SchreberjugendBV/DigitZ/StevensonScreen/README.md

In this folder you can find everythin you need to print and mount your own Stevenson Screen to protect temeraturesensor from sunlight
1.) Drawing as PDF
2.) 3mf file to print all parts on your 3D printer
3.) Autodesk Fusion file F3Z of the assembly with all parts. Feel free to modyfy and optimize the design.
Things to buy:
3 pcs of threaded bar M3
6 pcs distance bolts M3x10 brass
1 pc hex-screw M5x16 or longer
