SchreberjugendBV/DigitZ/Housing/chimney.stl

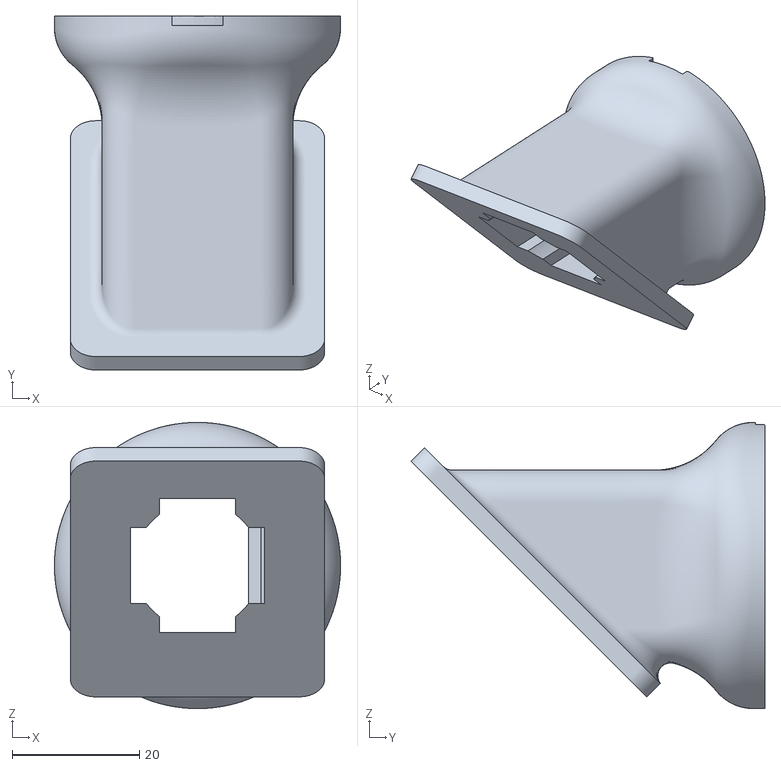
[picture p1: CAD file, 2025-11-23]
Housing/chimney.stl
45.0 x 55.7 x 45.0
