SchreberjugendBV/DigitZ/StevensonScreen/StevensonScreen_for_BambulabX1Carbon.3mf

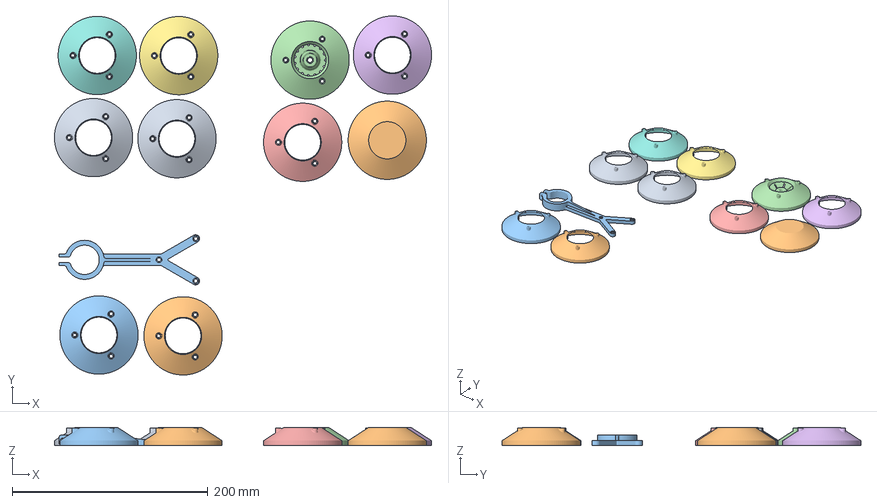
[picture p2: CAD file, 2025-11-19]
StevensonScreen/StevensonScreen_for_BambulabX1Carbon.3mf
385.5 x 367.0 x 18.6 mm
Shield v6.stl x 8
Top v3.obj
Stephenson_Halter v4.stl
Bottom v7.stl
