SchreberjugendBV/DigitZ/(list of files, cad)

Other CAD files:
Housing/Chimney.f3d
StevensonScreen/StevensonScreen.f3z
