SchreberjugendBV/DigitZ/Housing/HousingDrawings.pdf

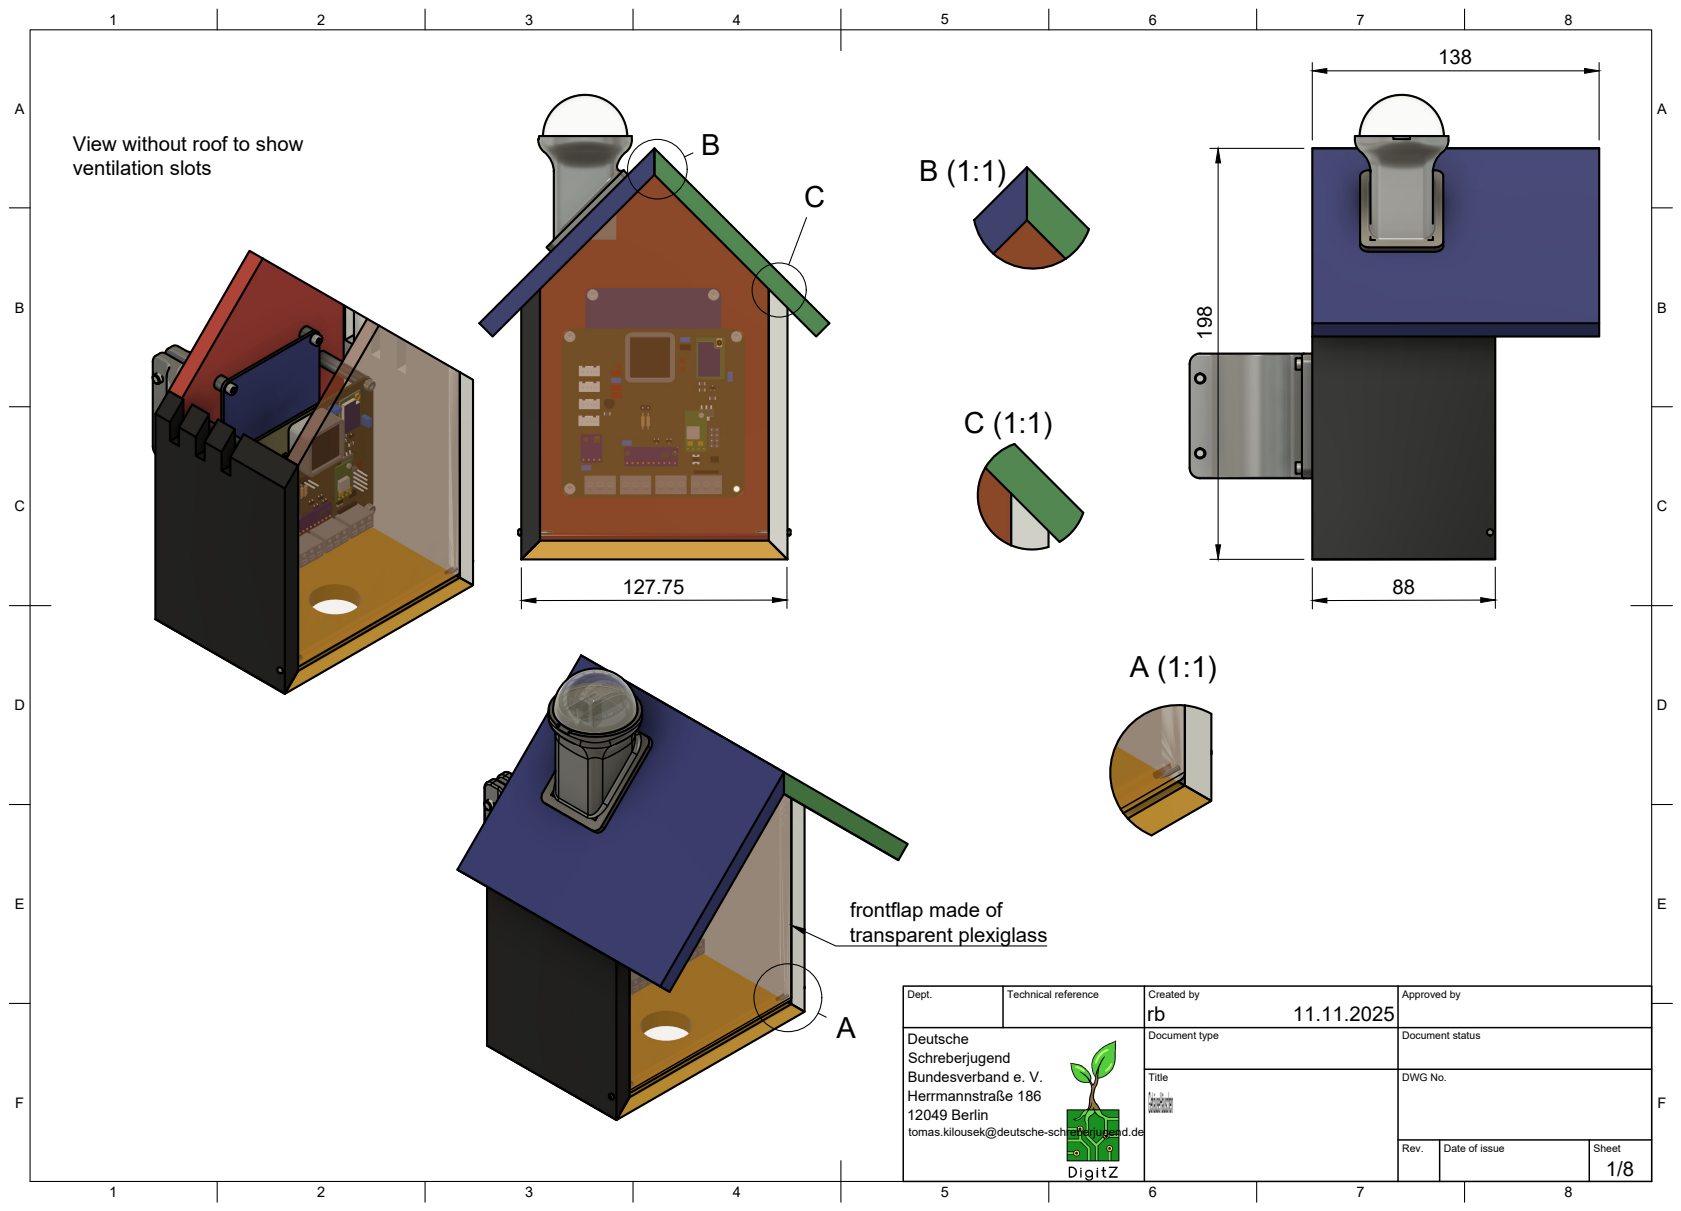
[picture p3: page 1]
Title; DWG No.; Rev.; Date of issue; Sheet

View without roof to show
ventilation slots

frontflap made of
transparent plexiglass

Dept. | Technical reference | Created by rb 11.11.2025 | Approved by

Deutsche
Schreberjugend
Bundesverband e. V.
Herrmannstraße 186
12049 Berlin
tomas.kilousek@deutsche-schreberjugend.de

Document type | Document status

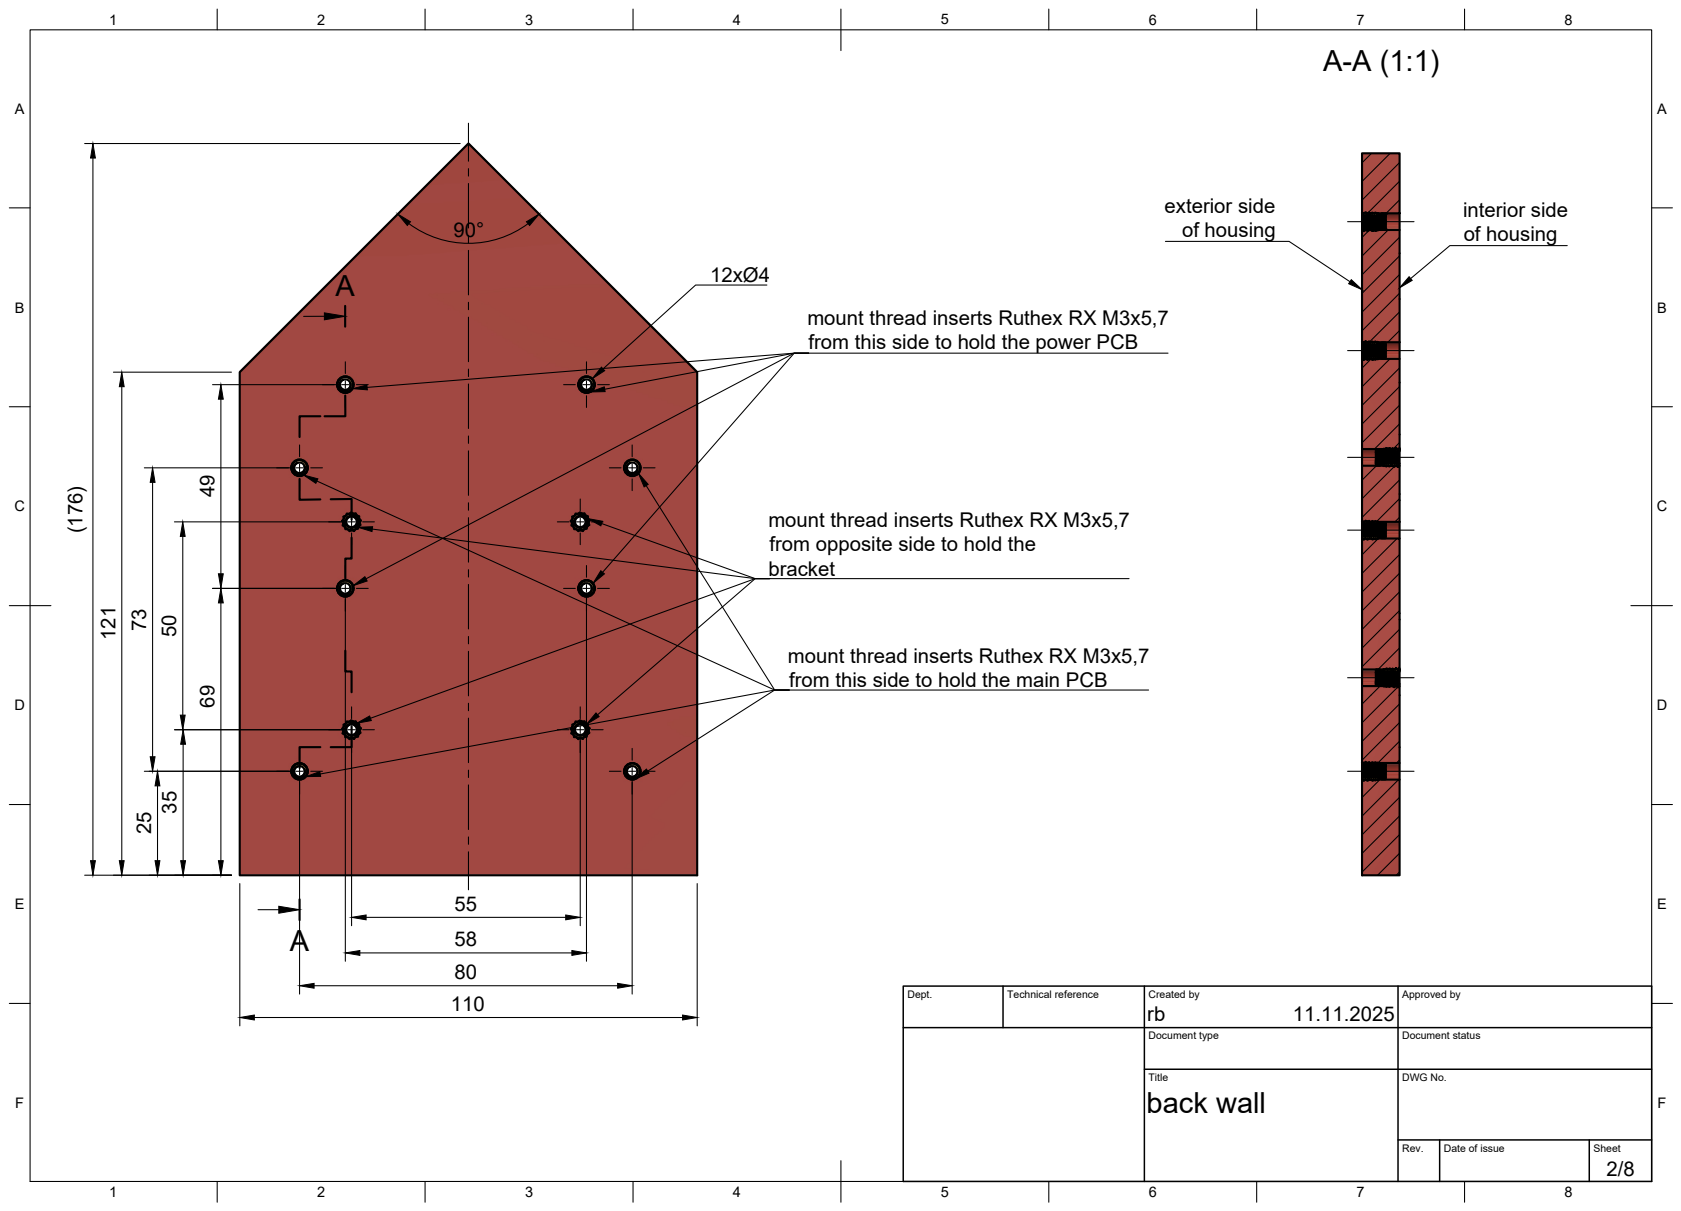
[picture p4: page 2]
Title; DWG No.; back wall; bracket 121; exterior side of housing; interior side of housing

mount thread inserts Ruthex RX M3x5,7
from this side to hold the power PCB

from opposite side to hold the

from this side to hold the main PCB

Dept. | Technical reference | Created by 11.11.2025 | Approved by

Document type | Document status

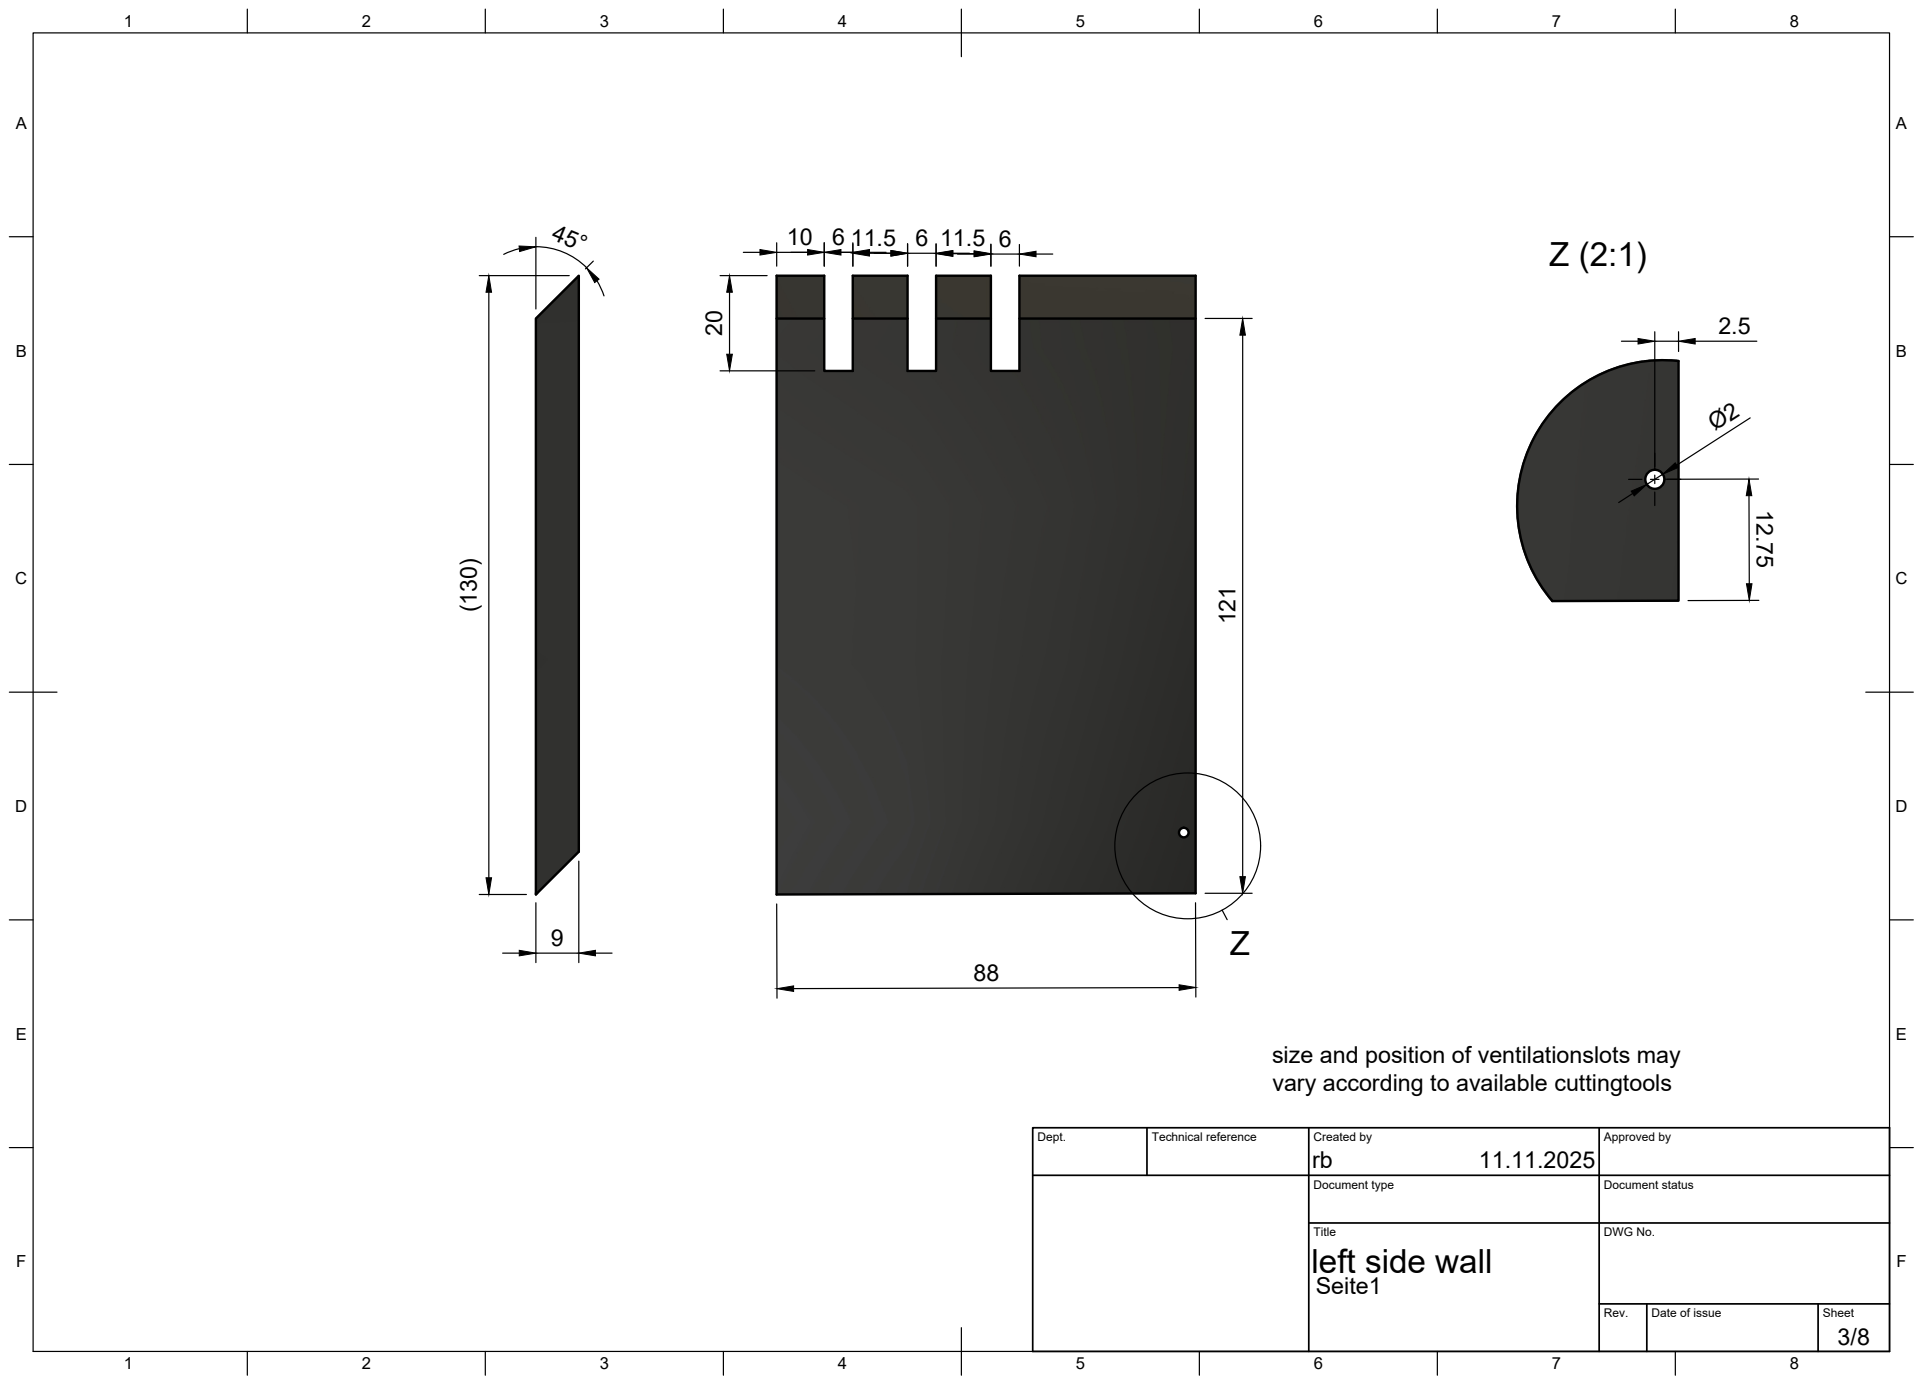
[picture p5: page 3]
Title; DWG No.

vary according to available cuttingtools 20

size and position of ventilationslots may

Dept. | Technical reference | Created by rb 11.11.2025 | Approved by

Document type | Document status

left side wall

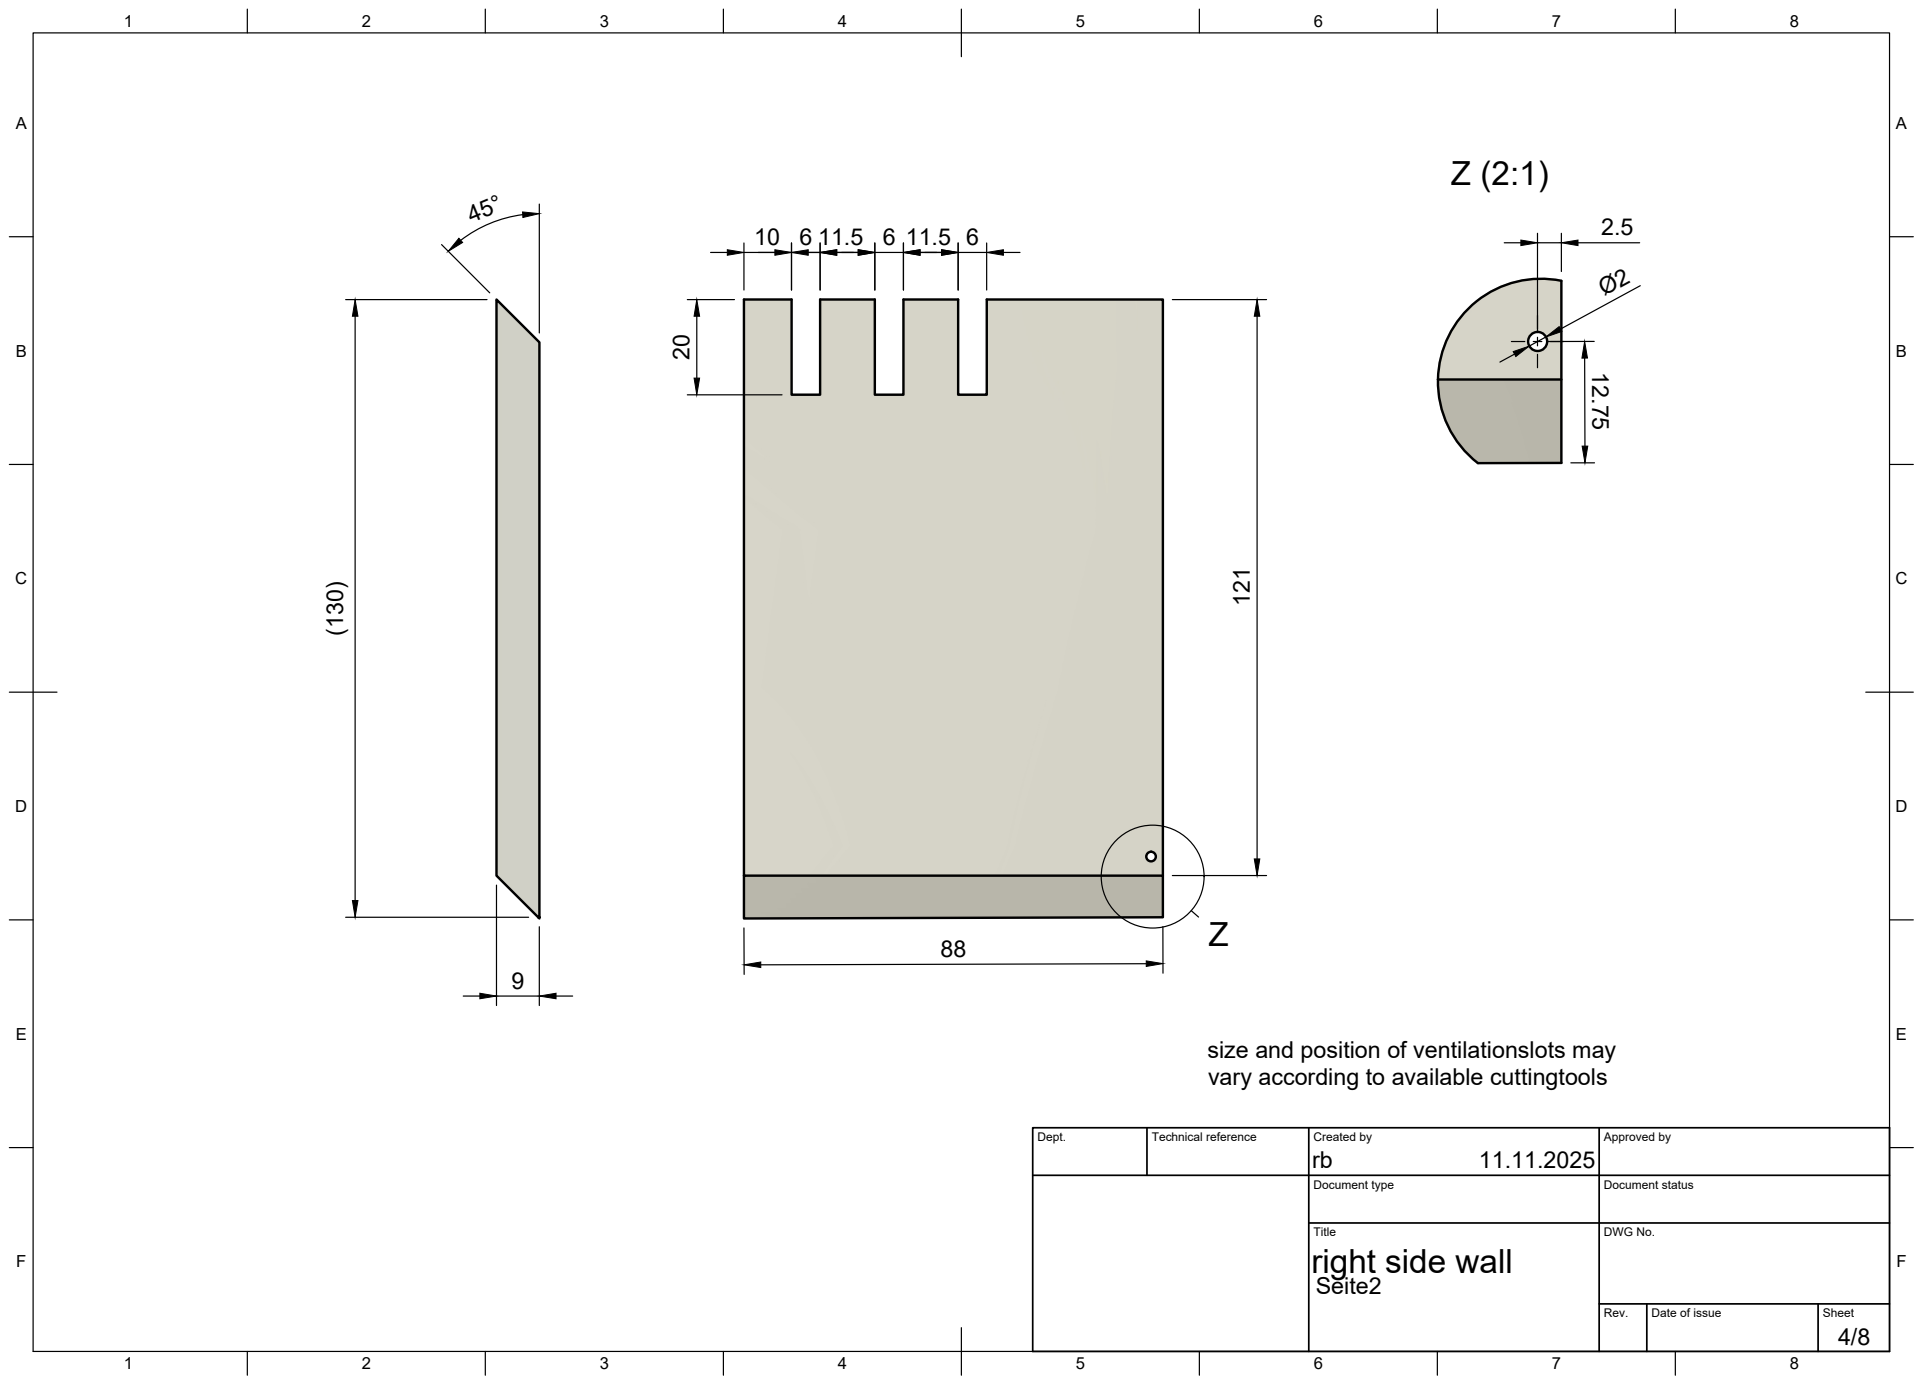
[picture p6: page 4]
Title; DWG No.

size and position of ventilationslots may
vary according to available cuttingtools

Dept. | Technical reference | Created by rb 11.11.2025 | Approved by

Document type | Document status

right side wall

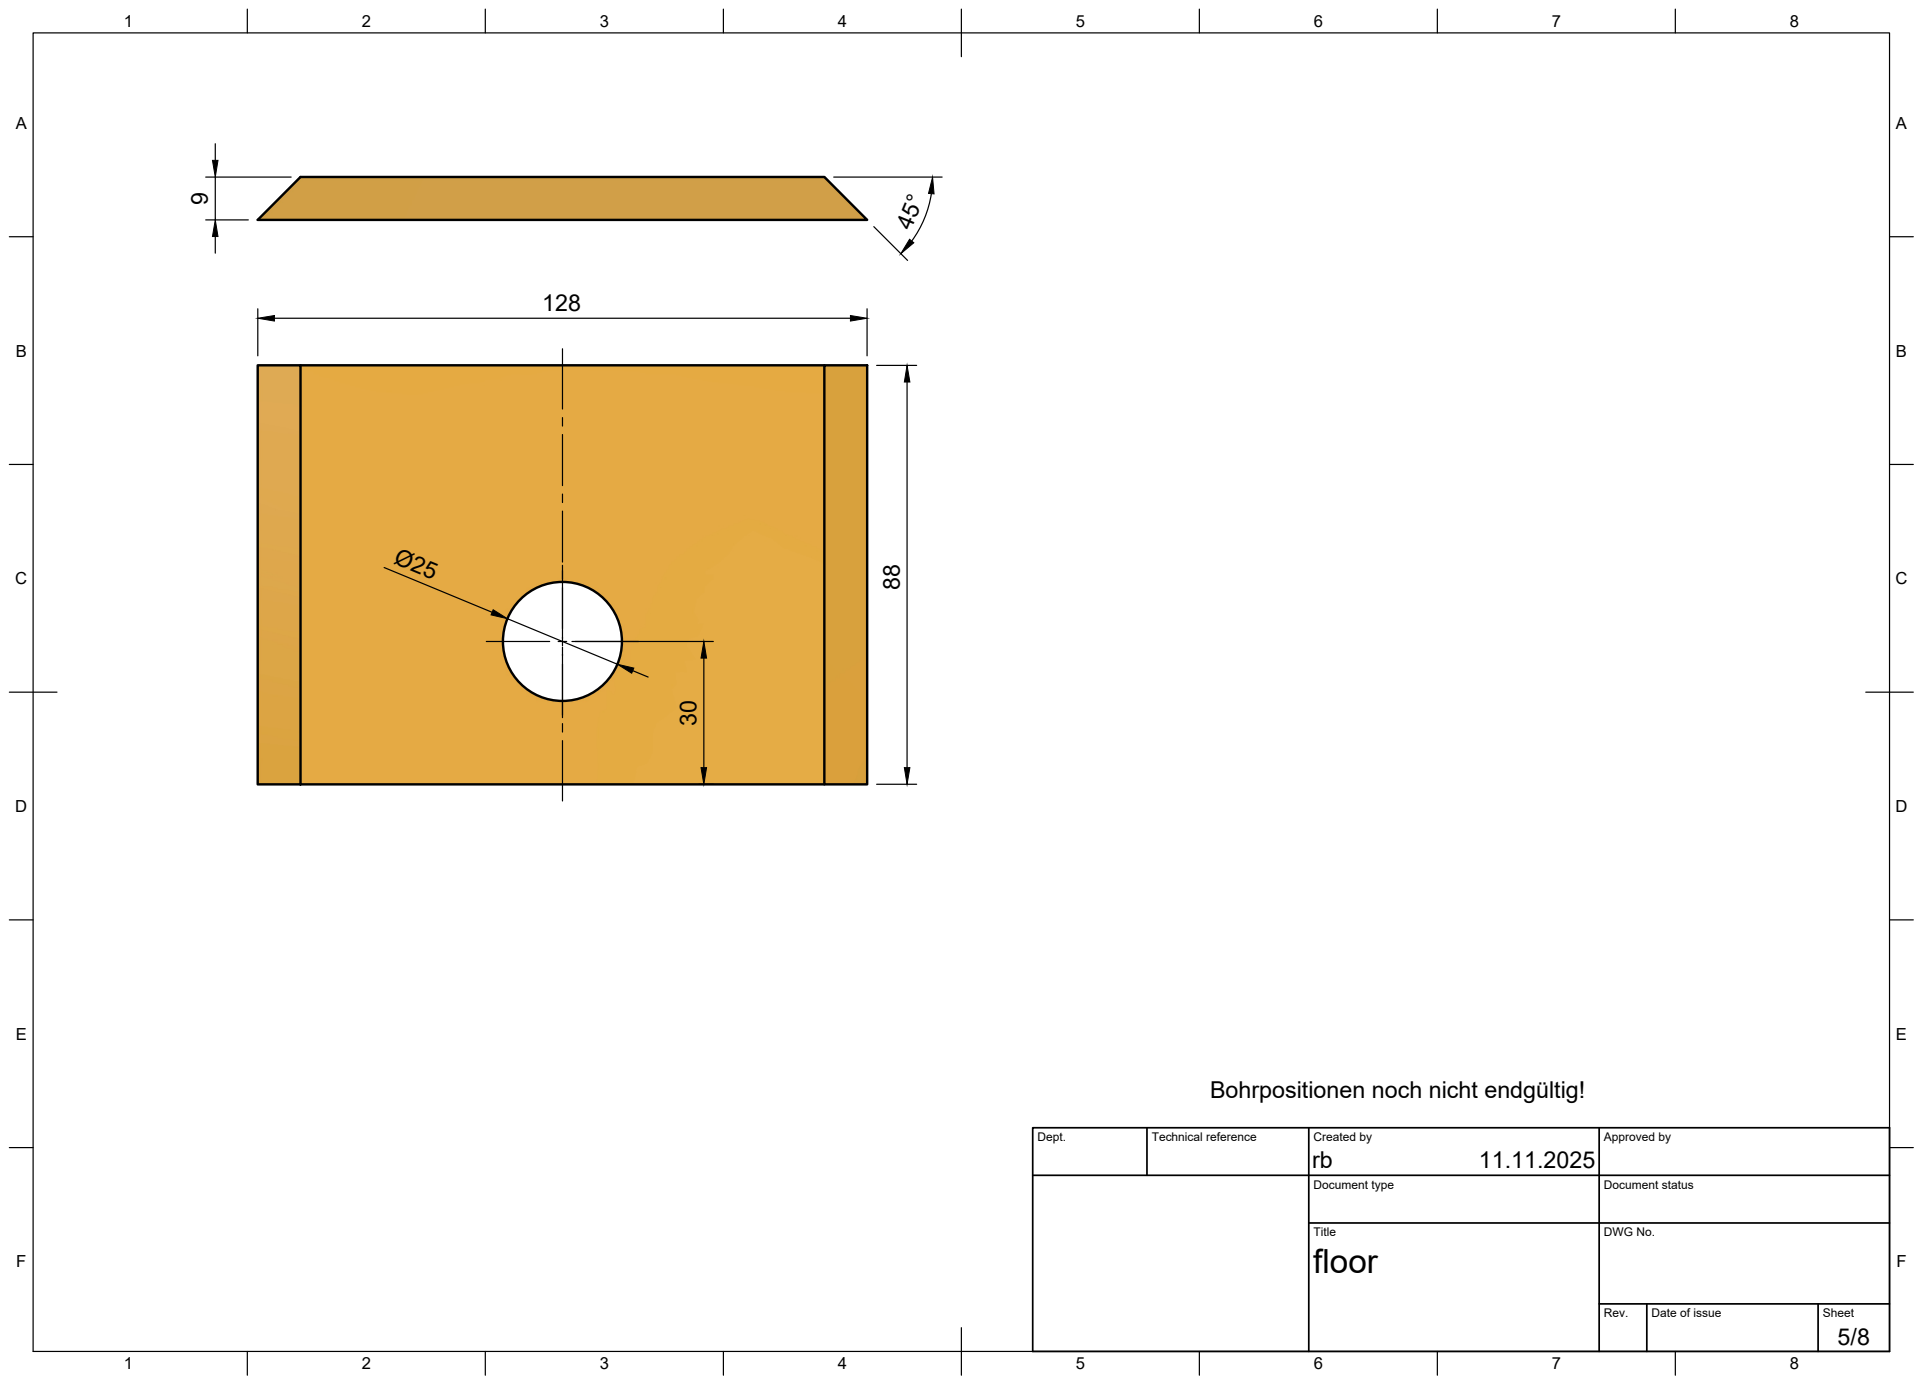
[picture p7: page 5]
Title; DWG No.

Bohrpositionen noch nicht endgültig!

Dept. | Technical reference | Created by rb 11.11.2025 | Approved by

Document type | Document status

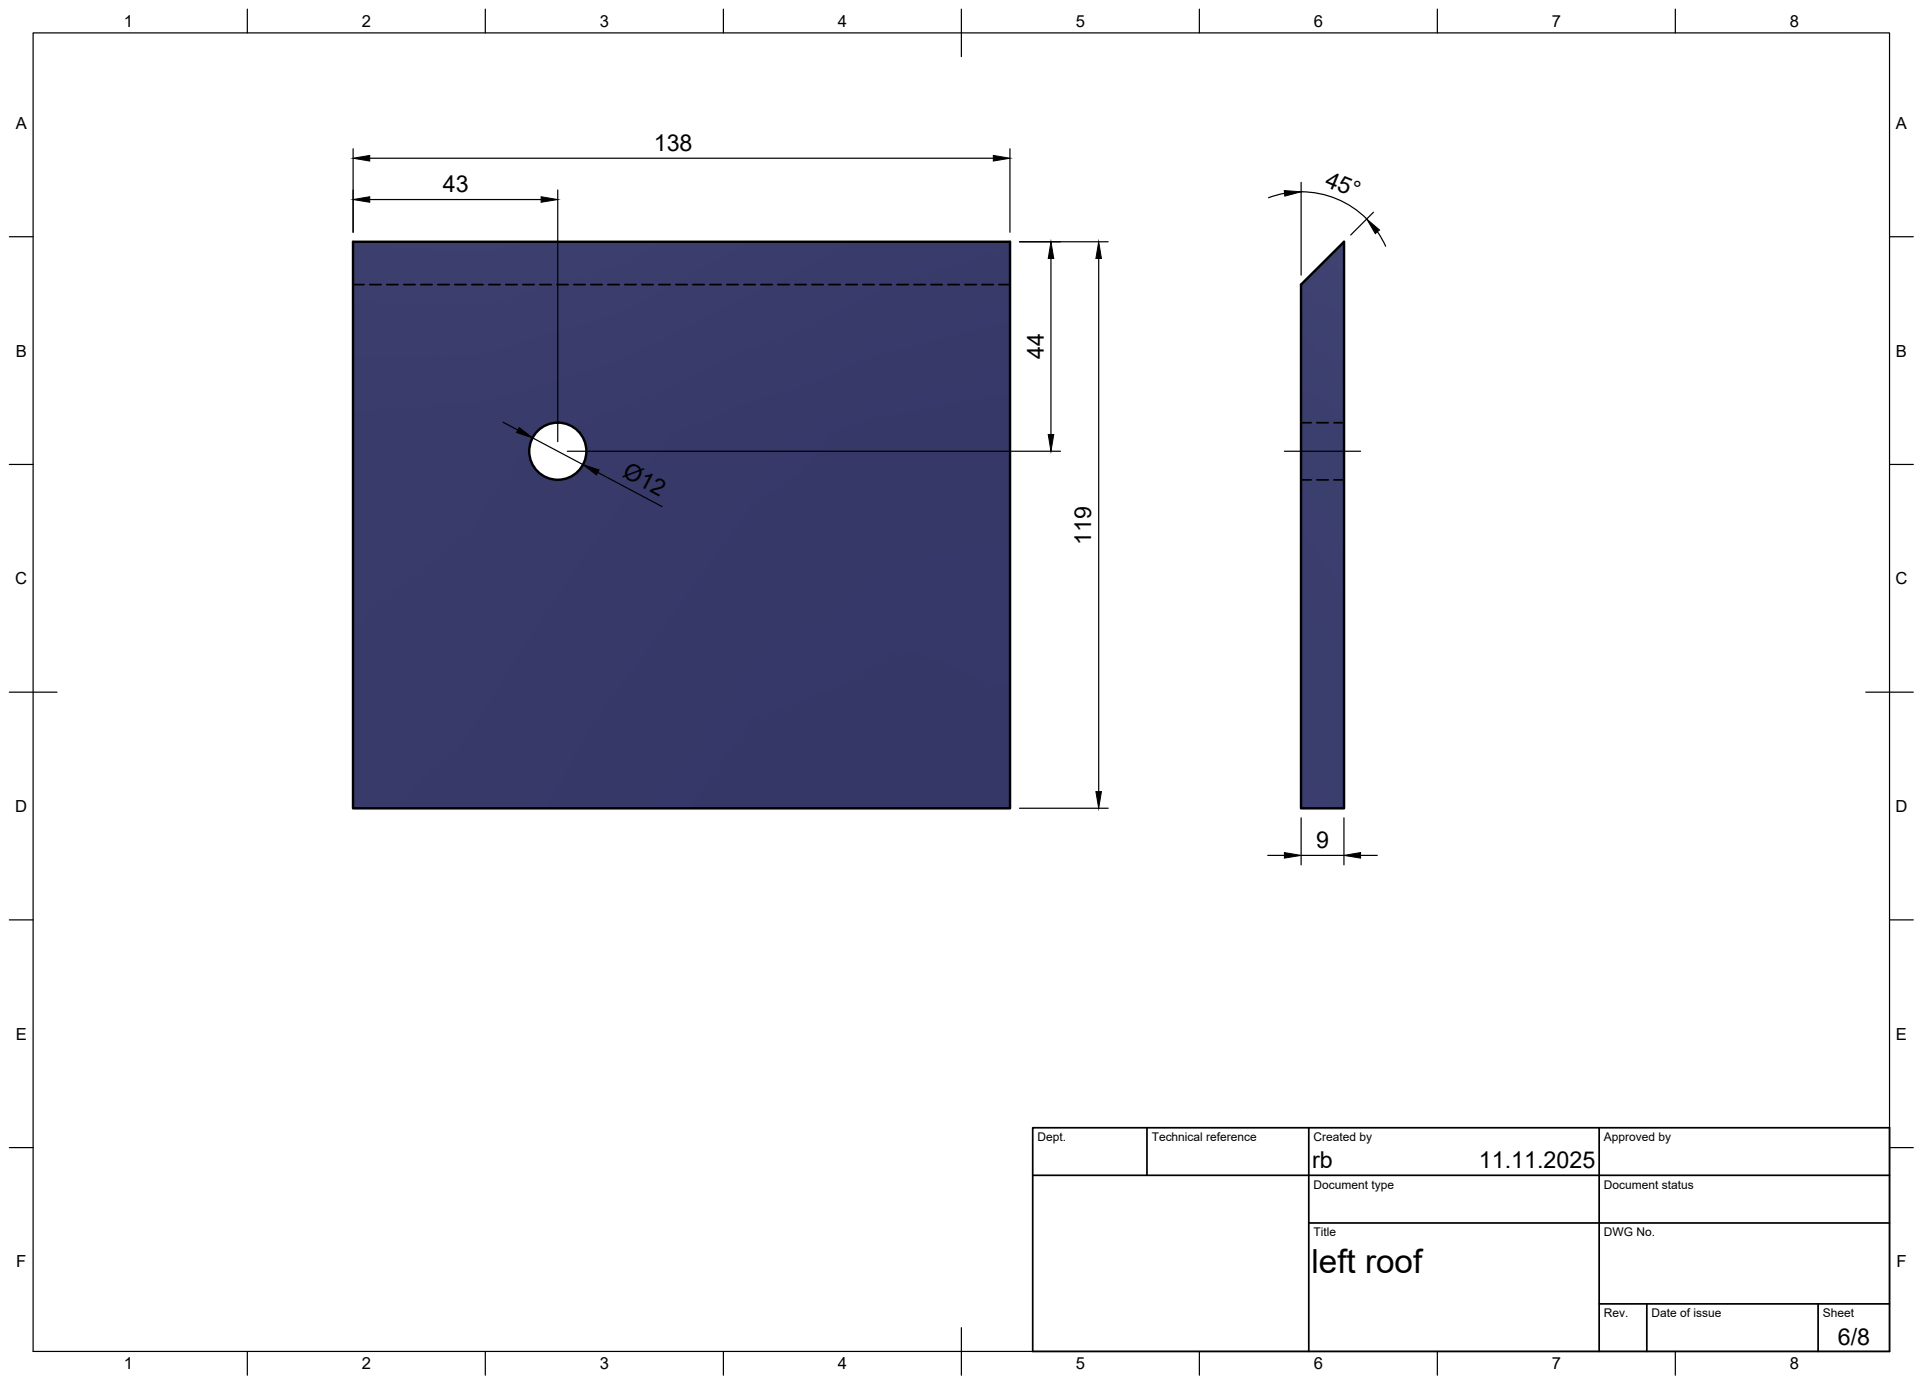
[picture p8: page 6]
Title; DWG No.; left roof

Dept. | Technical reference | Created by rb 11.11.2025 | Approved by

Document type | Document status

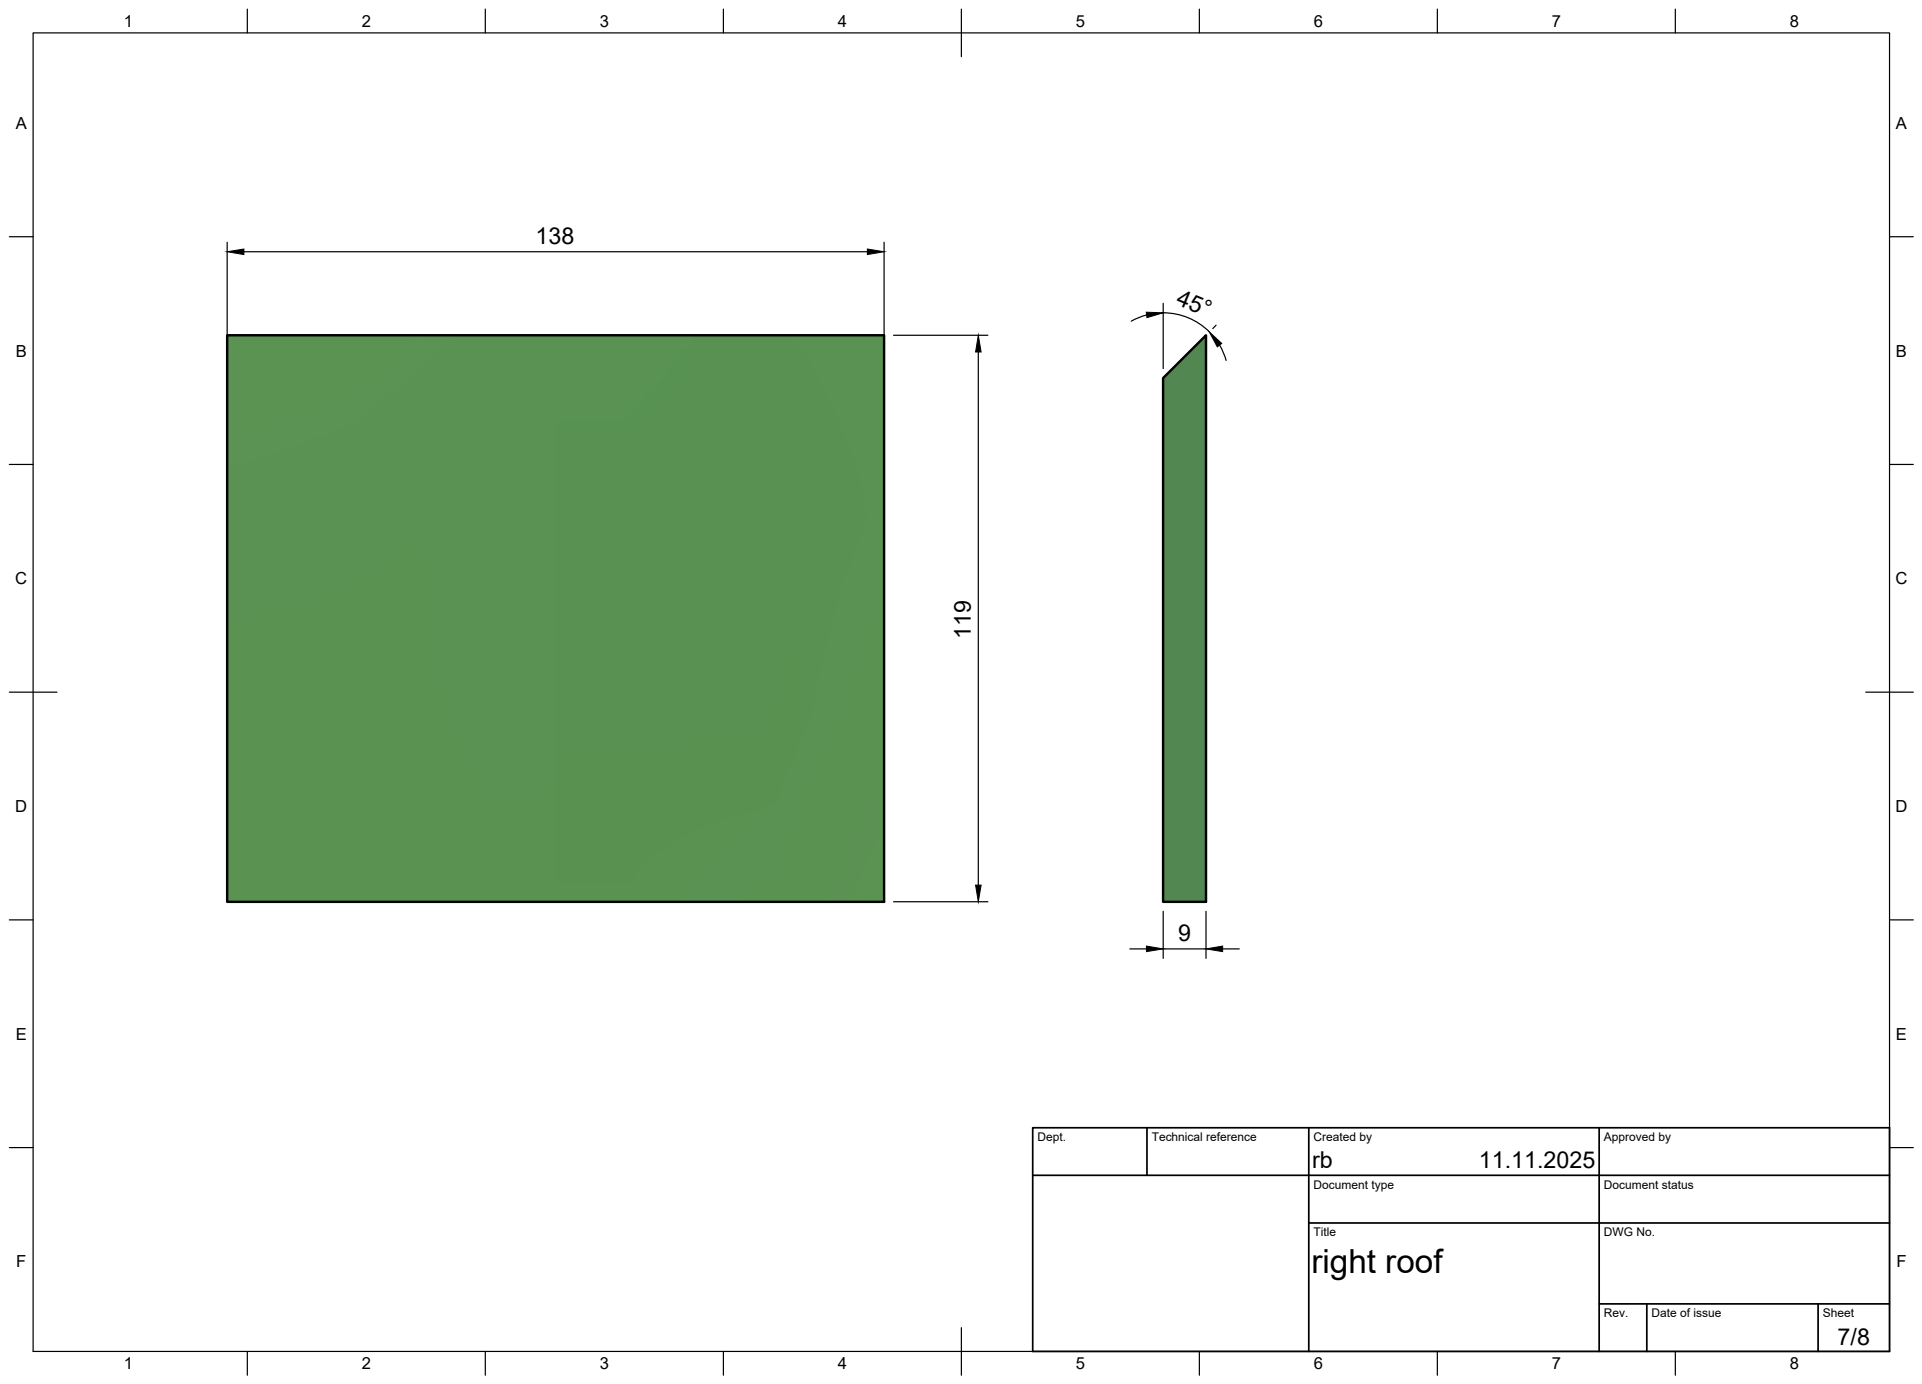
[picture p9: page 7]
Title; DWG No.; right roof

Dept. | Technical reference | Created by rb 11.11.2025 | Approved by

Document type | Document status

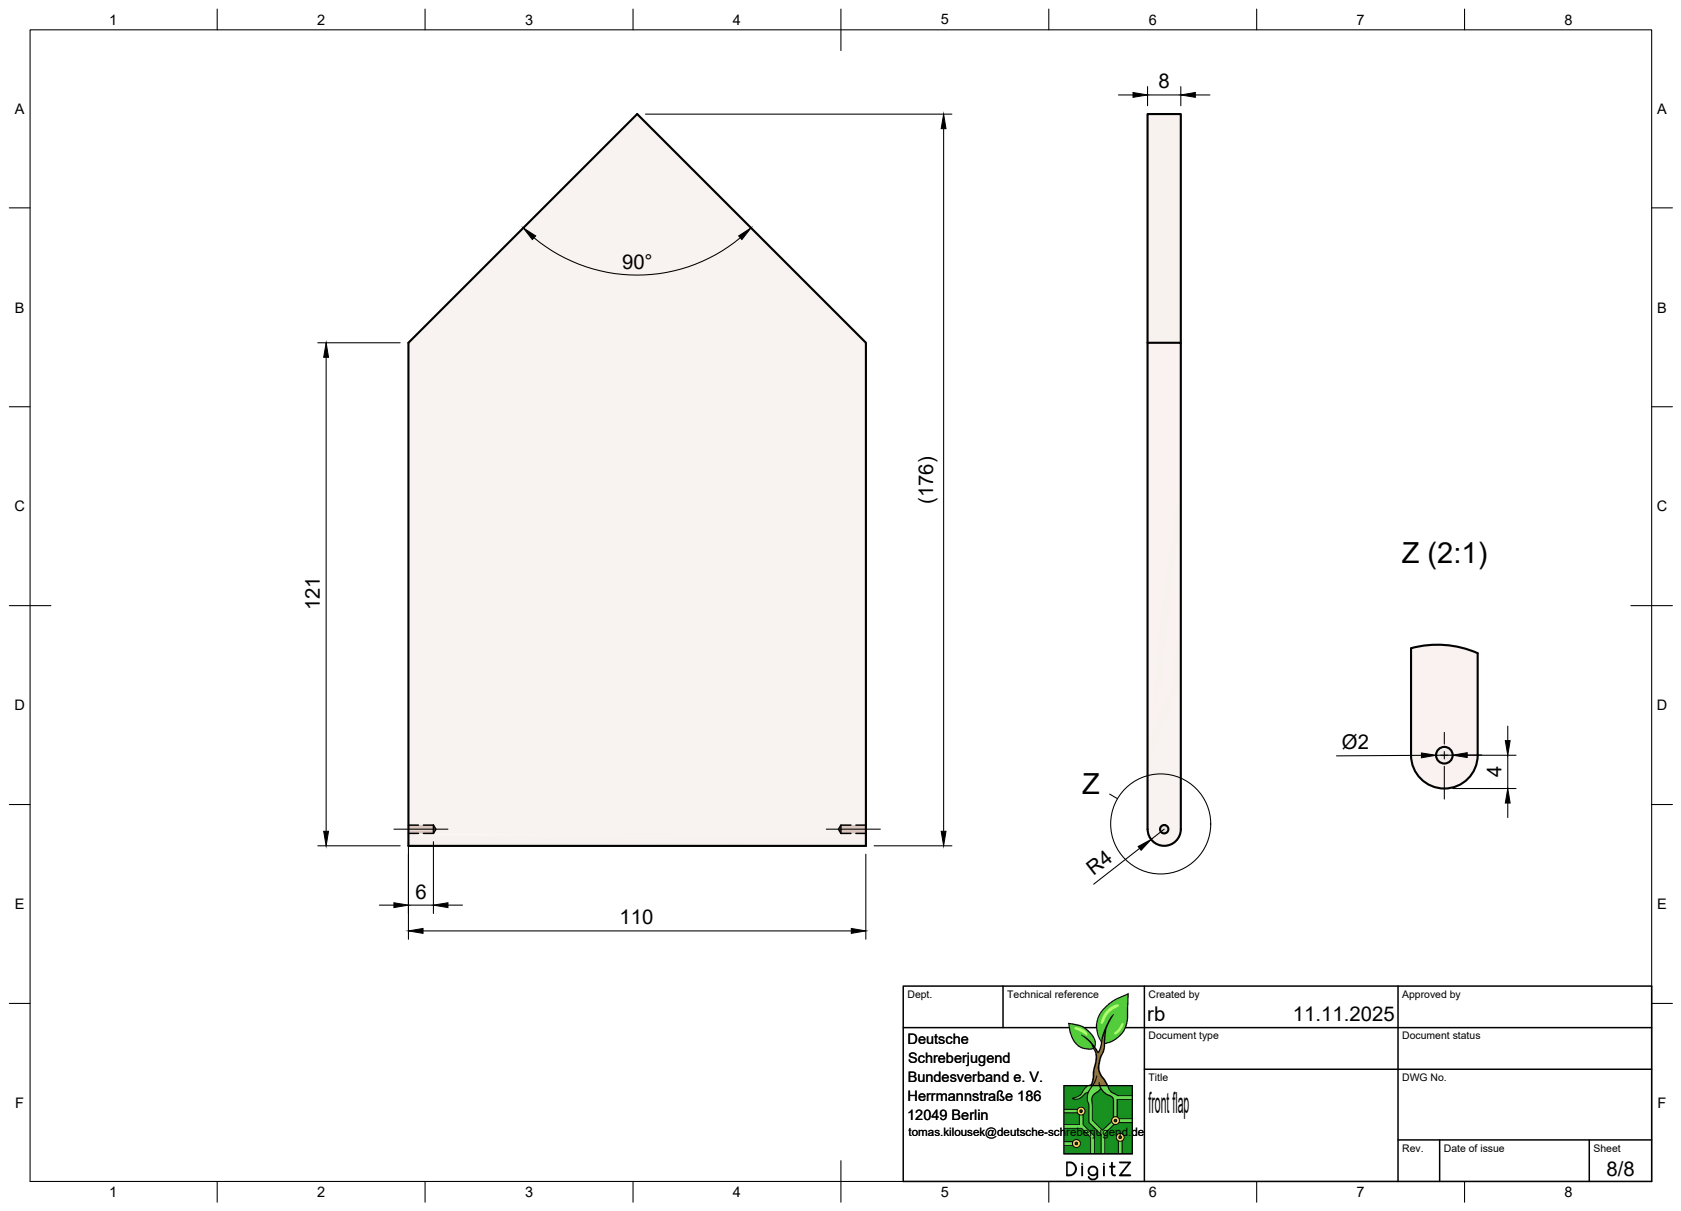
[picture p10: page 8]
Title; DWG No.; front flap

Dept. | Technical reference | Created by rb 11.11.2025 | Approved by

Deutsche
Schreberjugend
Bundesverband e. V.
Herrmannstraße 186
12049 Berlin
tomas.kilousek@deutsche-schreberjugend.de

Document type | Document status
