SchreberjugendBV/DigitZ/Main-PCB/Sensorboard-BRD.pdf

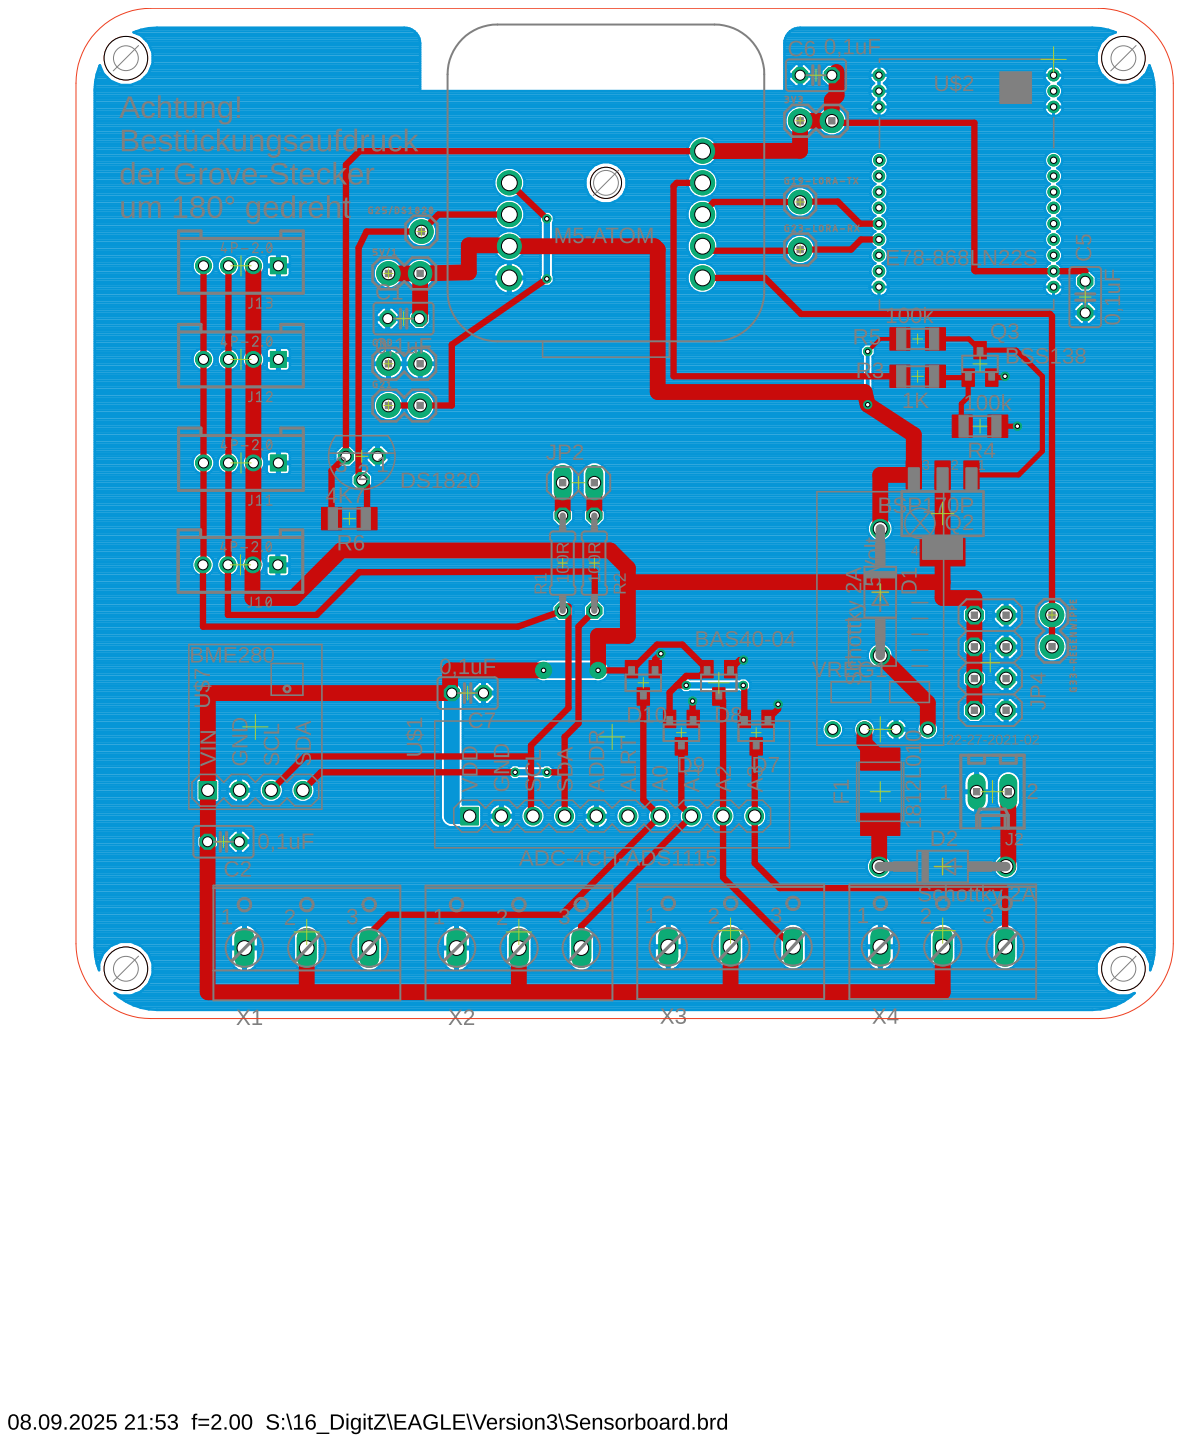
[picture p11: page 1]
