SchreberjugendBV/DigitZ/Main-PCB/Sensorboard-SCH.pdf

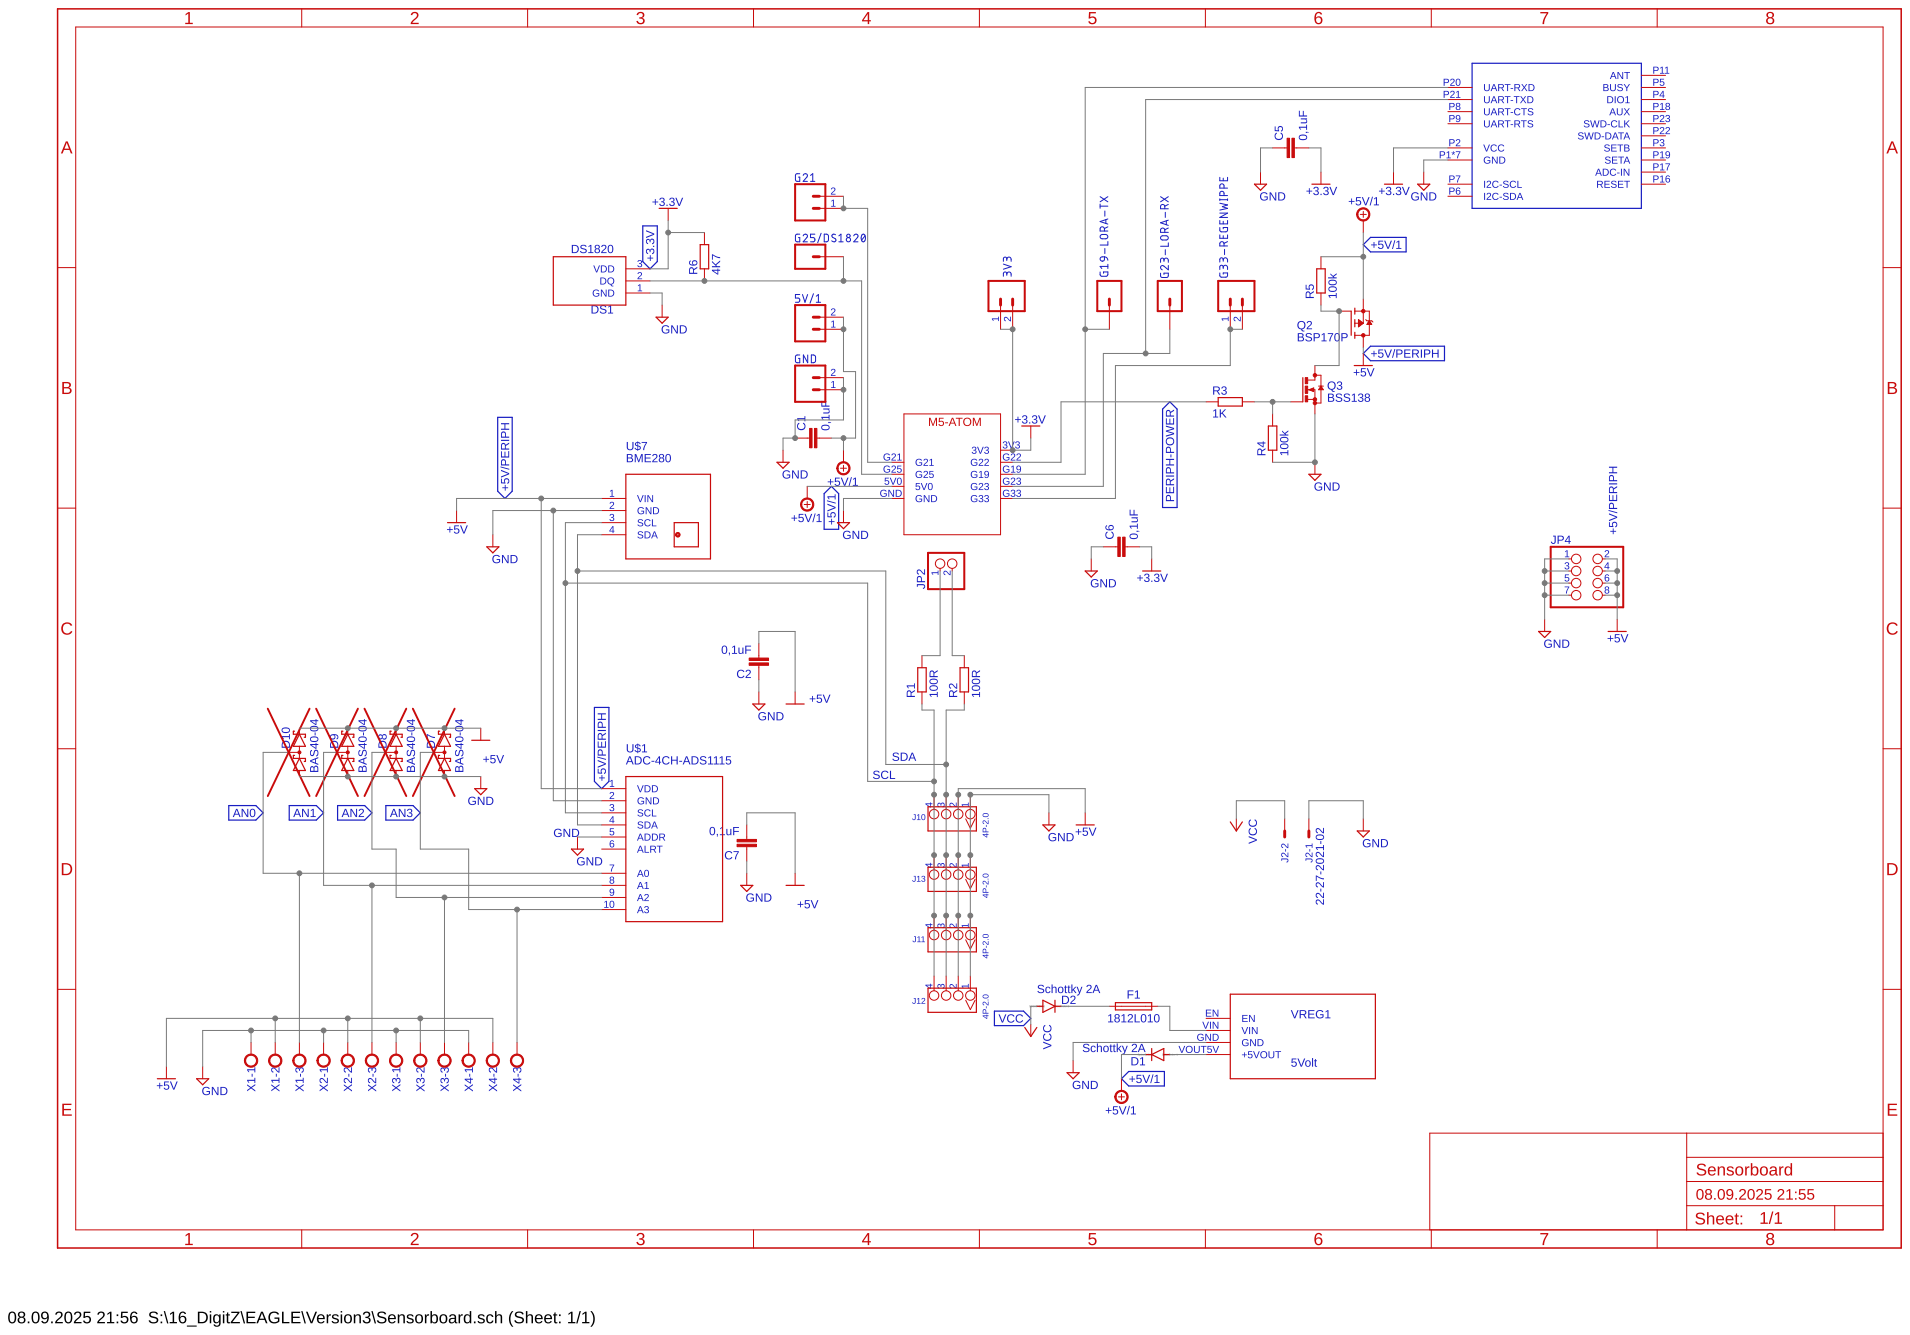
[picture p12: page 1]
