SchreberjugendBV/DigitZ/StevensonScreen/StevensonScreen.pdf

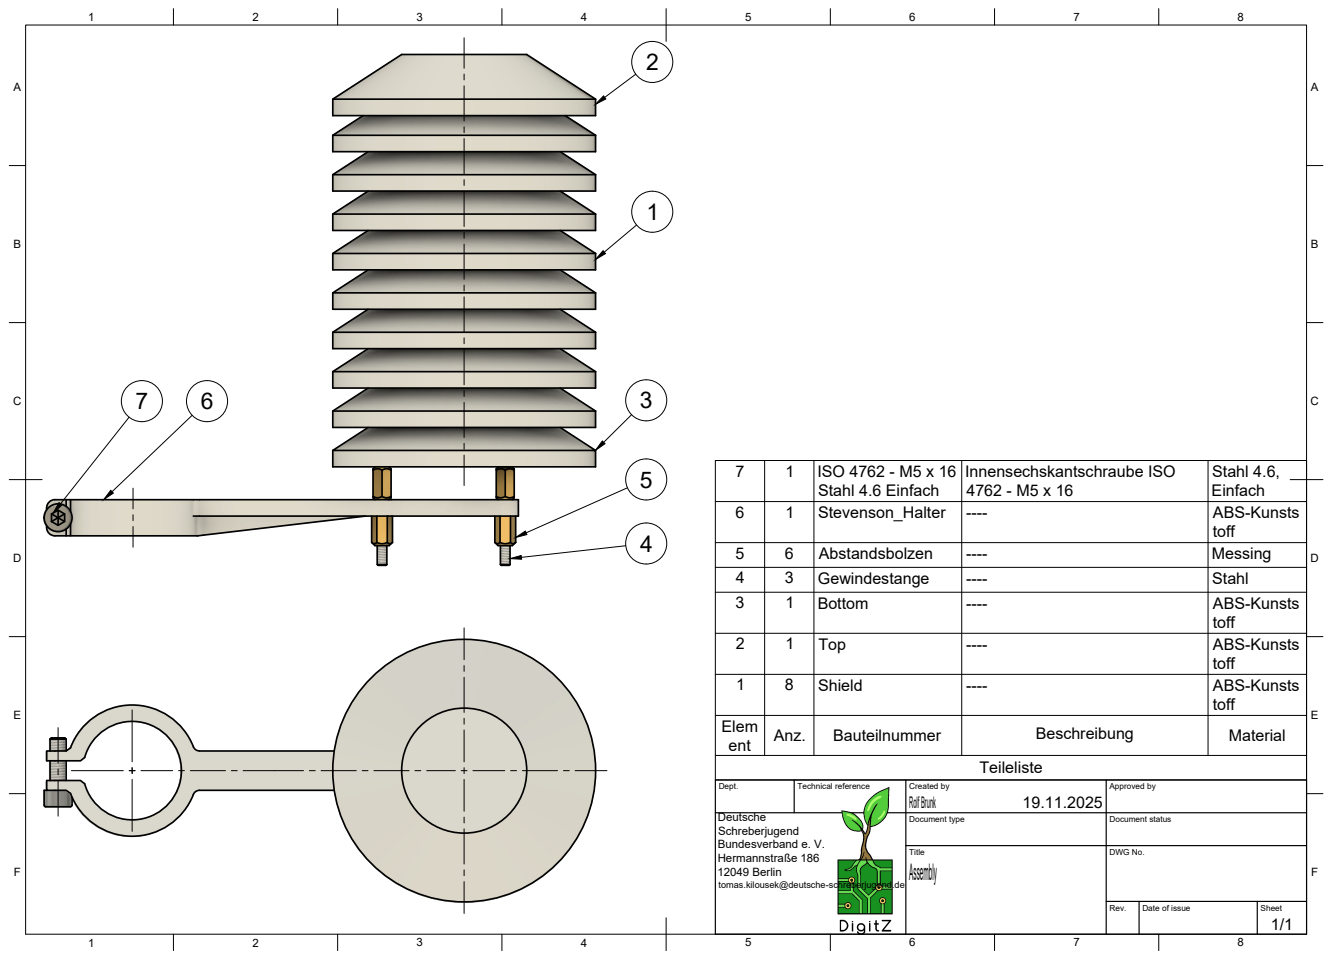
[picture p13: page 1]
Title; DWG No.; Rev.; Date of issue; Sheet

7 | 1 | ISO 4762 - M5 x 16 Stahl 4.6 Einfach | Innensechskantschraube ISO 4762 - M5 x 16 | Stahl 4.6, Einfach

6 | 1 | Stevenson_Halter | ---- | ABS-Kunsts toff

5 | 6 | Abstandsbolzen | ---- | Messing
4 | 3 | Gewindestange | ---- | Stahl
3 | 1 | Bottom | ---- | ABS-Kunsts toff

2 | 1 | Top | ---- | ABS-Kunsts toff

1 | 8 | Shield | ---- | ABS-Kunsts toff

Elem ent | Anz. | Bauteilnummer | Beschreibung | Material

Dept. | Technical reference | Created by Rolf Brunk 19.11.2025 | Approved by

Deutsche
Schreberjugend
Bundesverband e. V.
Hermannstraße 186
12049 Berlin
tomas.kilousek@deutsche-schreberjugend.de

Document type | Document status
