SchreberjugendBV/DigitZ/Main-PCB/Sensorboard.brd

## EAGLE design Main-PCB/Sensorboard.brd (2025-11-23)

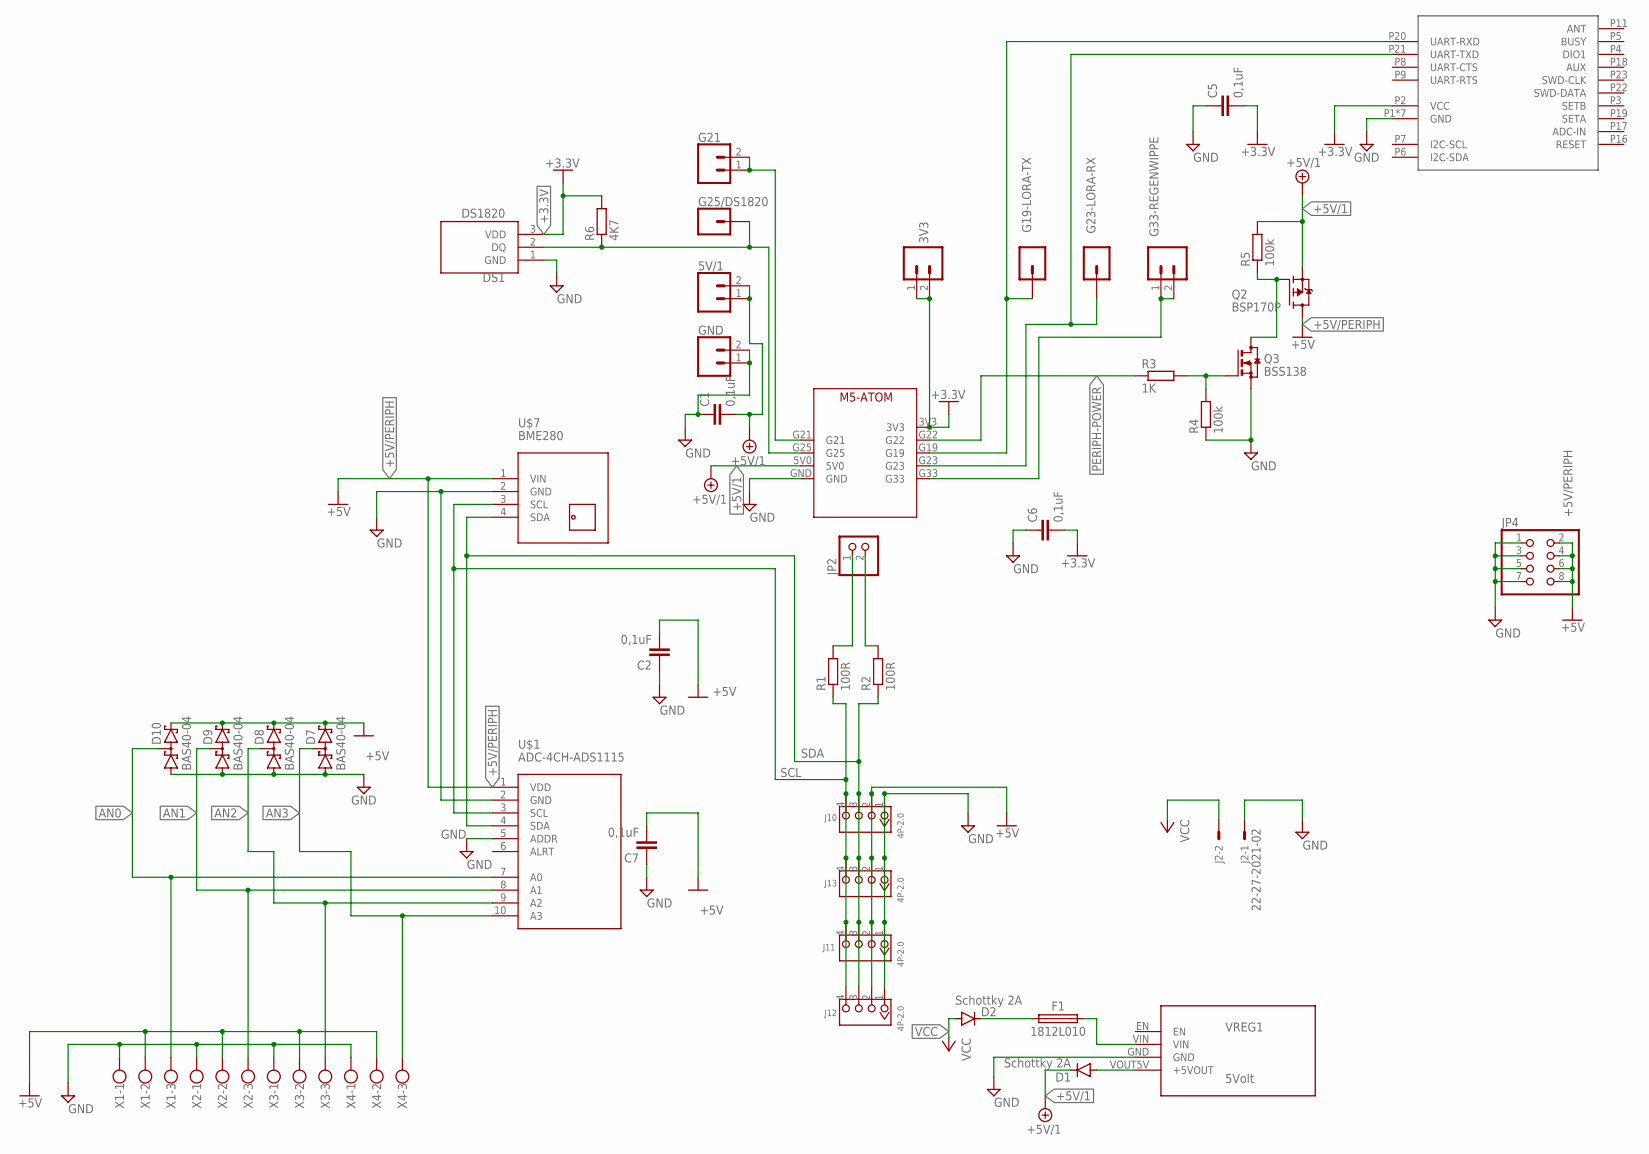
[picture p14: schematic Sensorboard.sch]

Parts:
3V3, 5V/1: CONN_02; 1X02
C1, C2, C5, C6, C7: 0,1uF; C025-025X050
D1, D2: Schottky 2A; DO41-10
D7, D8, D9, D10: BAS40-04; SOT23
DS1: DS1820; DS1820-TO92
F1: 1812L010; FUSC4532X125
G19-LORA-TX, G23-LORA-RX, G25/DS1820: CONN_01; 1X01
G21, G33-REGENWIPPE: CONN_02; 1X02
GND: CONN_02; 1X02
J2: 22-27-2021-02; 6410-02
J10, J11, J12, J13: 4P-2.0; HW4-2.0
JP2: PINHD-1X2; 1X02
JP4: PINHD-2X4; 2X04
M5-ATOM: M5-ATOM
Q2: BSP170P; SOT223
Q3: BSS138; SOT23
R1, R2: 100R; 0204/7
R3: 1K; R1206
R4, R5: 100k; R1206
R6: 4K7; R1206
U$1: ADC-4CH-ADS1115
U$2: E78-868LN22S
U$7: BME280; TEMP-HUM-PRES-BME280
VREG1: 5Volt; VREG-STEPDOWN
X1, X2, X3, X4: W237-103-RB

Connections:
+3.3V: 3V3.1, 3V3.2, C5.2, C6.2, DS1.3 (VDD), M5-ATOM.3V3, R6.2, U$2.P2 (VCC)
+5V/1: 5V/1.1, 5V/1.2, C1.2, D1.C, M5-ATOM.5V0, Q2.3 (S), R5.2
+5V/PERIPH: C2.2, C7.2, D7.2 (C2), D8.2 (C2), D9.2 (C2), D10.2 (C2), J10.2, J11.2, J12.2, J13.2, JP4.2, JP4.4, JP4.6, JP4.8, Q2.2 (D), Q2.4 (D), U$1.1 (VDD), U$7.1 (VIN), X1.2, X2.2, X3.2, X4.2
AN0: D10.3 (C1A2), U$1.7 (A0), X1.3
AN1: D9.3 (C1A2), U$1.8 (A1), X2.3
AN2: D8.3 (C1A2), U$1.9 (A2), X3.3
AN3: D7.3 (C1A2), U$1.10 (A3), X4.3
GND: C1.1, C2.1, C5.1, C6.1, C7.1, D7.1 (A1), D8.1 (A1), D9.1 (A1), D10.1 (A1), DS1.1 (GND), GND.1, GND.2, J2.1, J10.1, J11.1, J12.1, J13.1, JP4.1, JP4.3, JP4.5, JP4.7, M5-ATOM.GND, Q3.2 (S), R4.1, U$1.2 (GND), U$1.5 (ADDR), U$2.P1 (GND), U$2.P10 (GND), U$2.P12 (GND), U$2.P13 (GND), U$2.P14 (GND), U$2.P15 (GND), U$2.P24 (GND), U$7.2 (GND), VREG1.GND, X1.1, X2.1, X3.1, X4.1
LORA-RX: G23-LORA-RX.1, M5-ATOM.G23, U$2.P21 (UART-TXD)
LORA-TX: G19-LORA-TX.1, M5-ATOM.G19, U$2.P20 (UART-RXD)
unnamed: G33-REGENWIPPE.1, G33-REGENWIPPE.2, M5-ATOM.G33
unnamed: JP2.1, R1.2
unnamed: DS1.2 (DQ), G25/DS1820.1, M5-ATOM.G25, R6.1
unnamed: G21.1, G21.2, M5-ATOM.G21
unnamed: JP2.2, R2.2
unnamed: D1.A, VREG1.VOUT5V (+5VOUT)
unnamed: Q3.1 (G), R3.2, R4.2
unnamed: D2.C, F1.1
unnamed: F1.2, VREG1.VIN
unnamed: Q2.1 (G), Q3.3 (D), R5.1
PERIPH-POWER: M5-ATOM.G22, R3.1
SCL: J10.4, J11.4, J12.4, J13.4, R1.1, U$1.3 (SCL), U$7.3 (SCL)
SDA: J10.3, J11.3, J12.3, J13.3, R2.1, U$1.4 (SDA), U$7.4 (SDA)
VCC: D2.A, J2.2

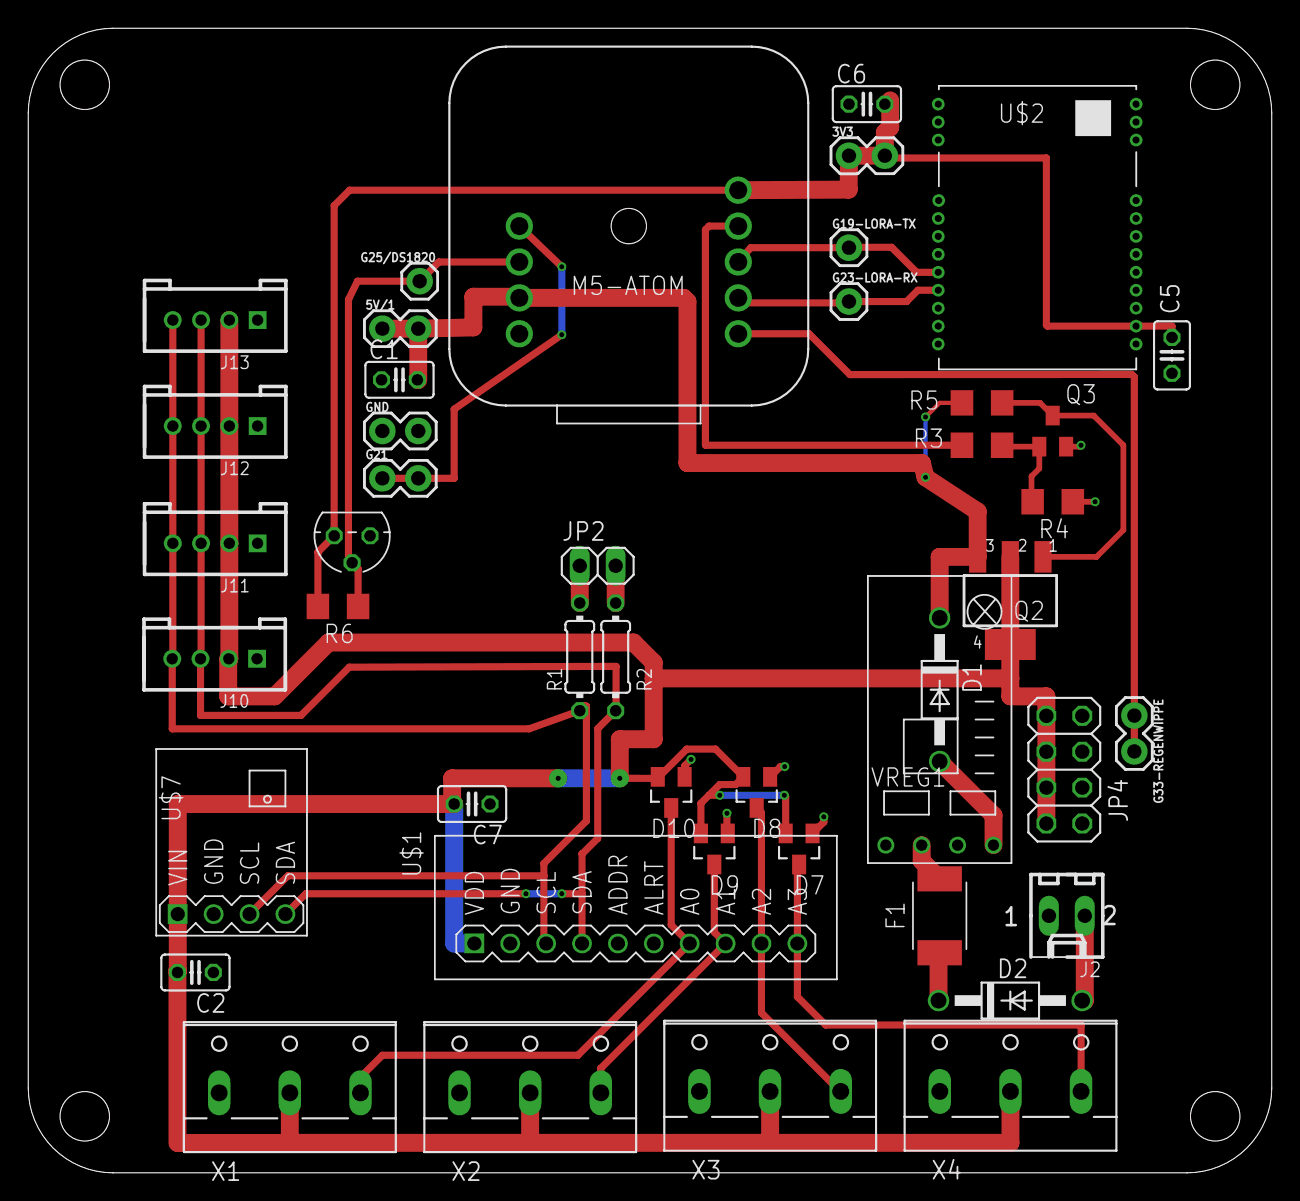
[picture p15: board Sensorboard.brd from above]

Board: 2 copper layers, 88.0 x 81.0 mm, 45 parts (0 on the bottom side), 24 nets.
